Bprepared/FB-32-CD32-Expansions/README.md

# FB-32-CD32-Expansions

This is a Commodore Amiga CD32 Expansion Project. The core of which is the FB-32R Riser which has been verified as working with the TerribleFire TF328
