Bprepared/FB-32-CD32-Expansions/FB-32G/KICAD/Rev2_2/FB-32Gamer Module Rev2_2.kicad_pcb

## KiCad design FB-32G/KICAD/Rev2_2/FB-32Gamer Module Rev2_2.kicad_pcb (2019-09-12)

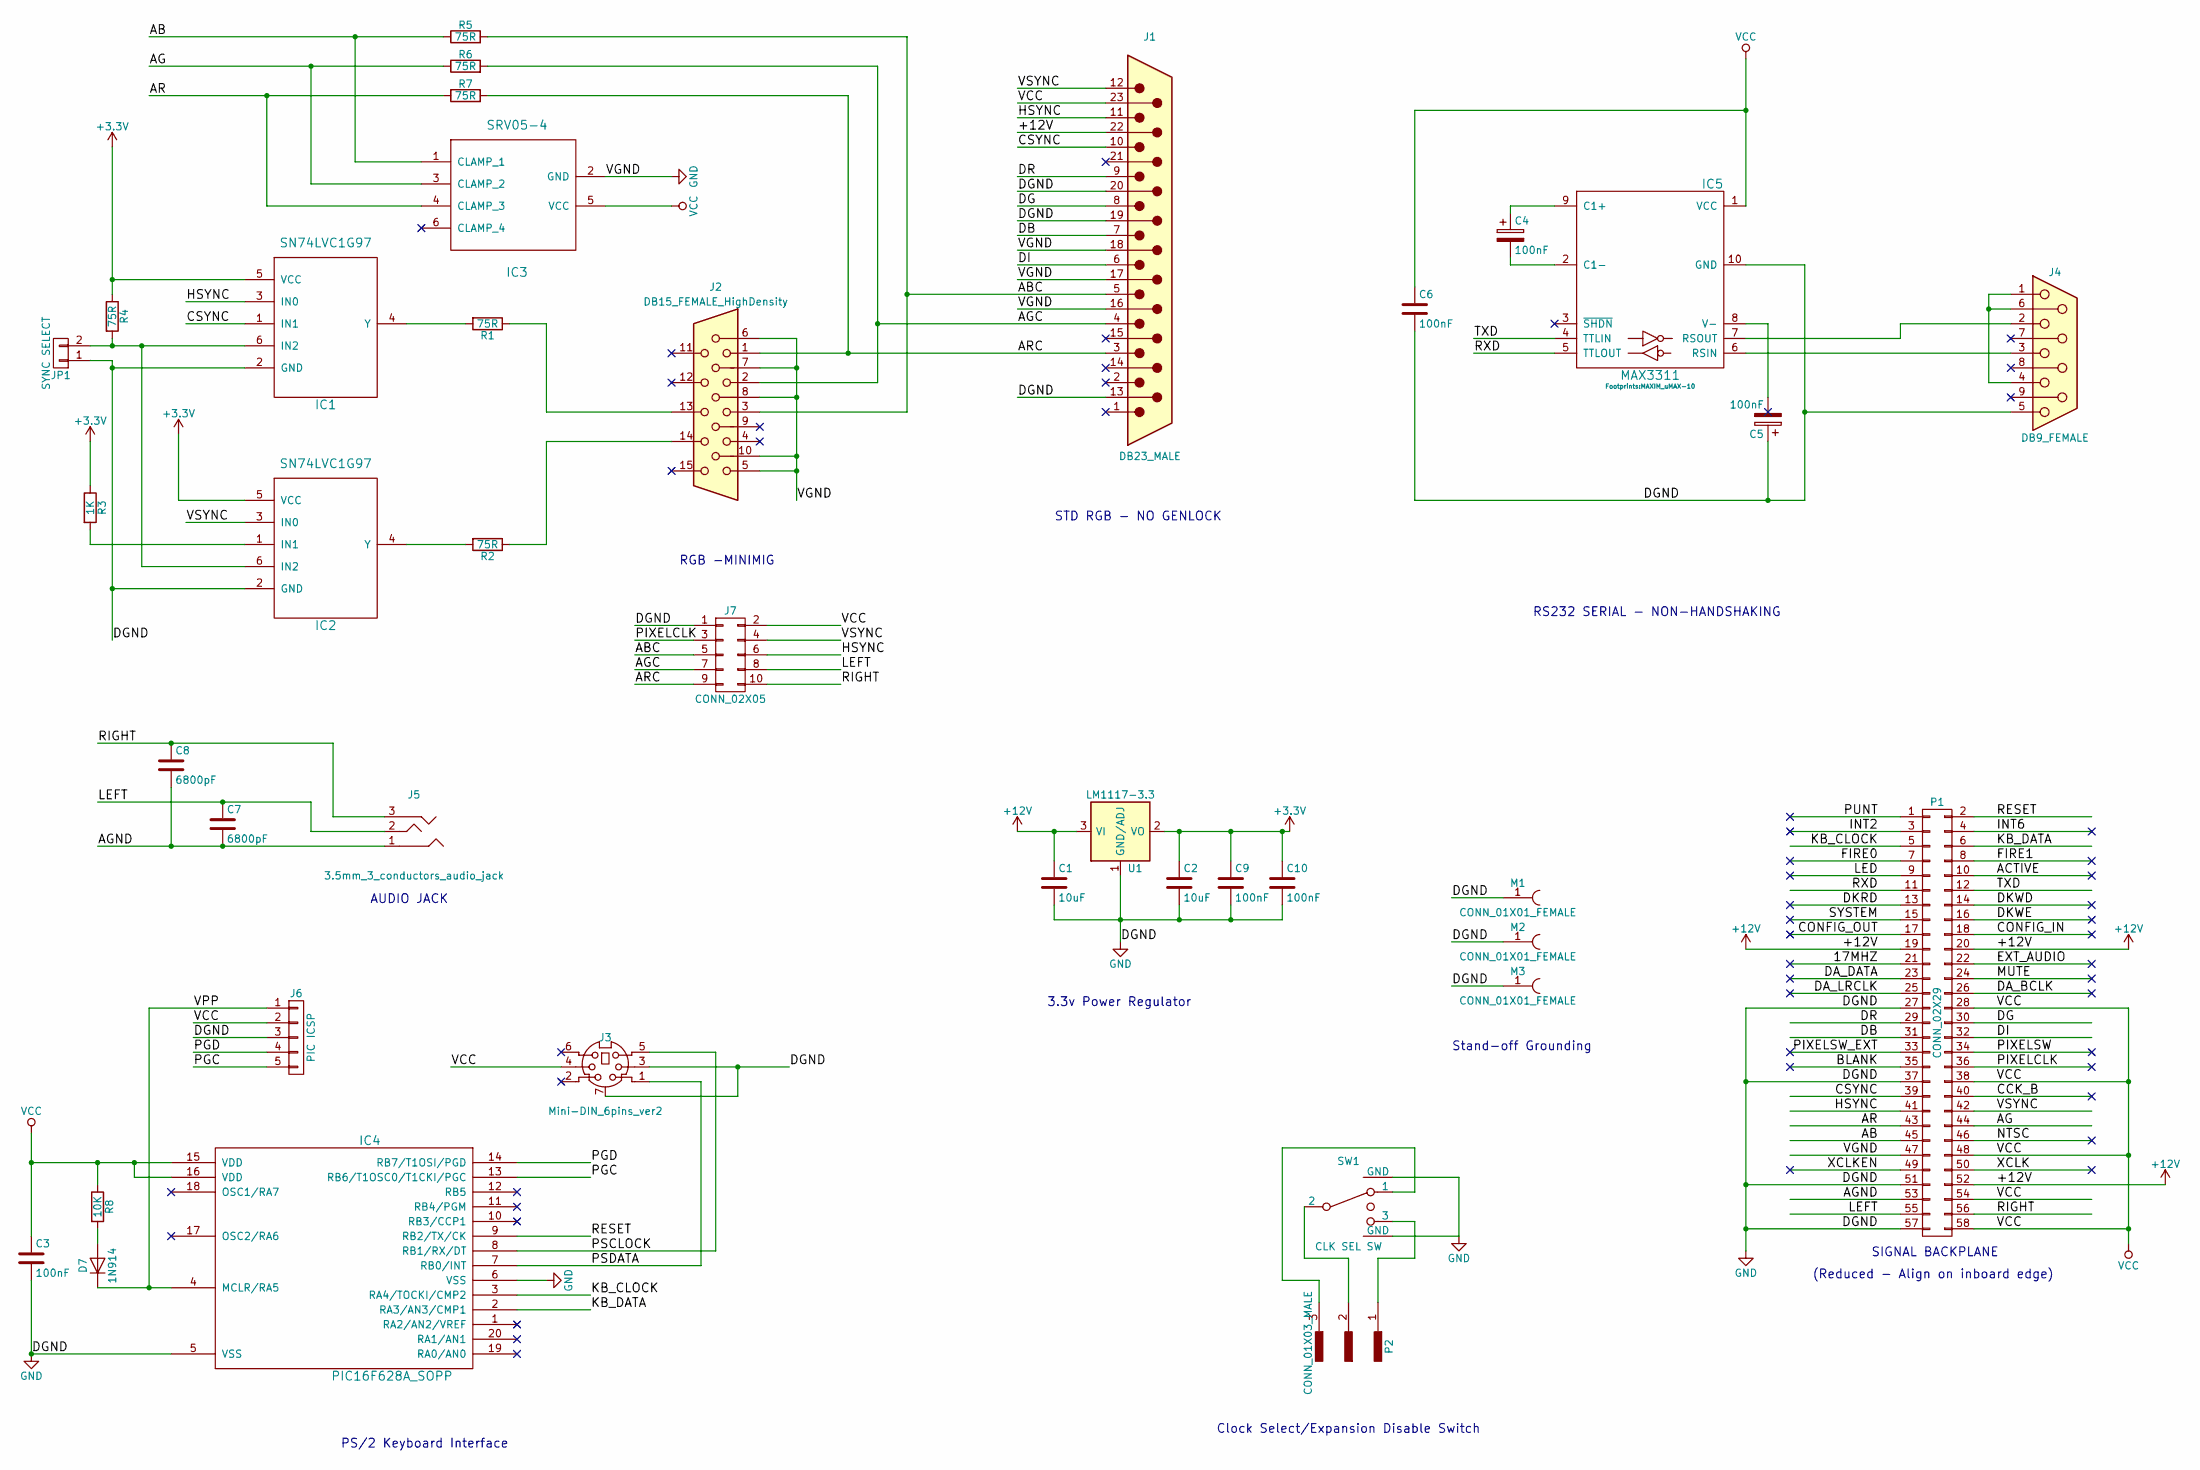
[picture p1: schematic FB-32Gamer Module Rev2_2.sch]

Parts:
C1, C2: 10uF; C_1206_HandSoldering
C3, C6, C9, C10: 100nF; C_0603_HandSoldering
C4, C5: 100nF; CP_Elec_3x5.3
C7, C8: 6800pF; C_0603_HandSoldering
D7: 1N914; D_SOD-323_HandSoldering
IC1, IC2: SN74LVC1G97; SOT-23-6_Handsoldering
IC3: SRV05-4; SOT-23-6_Handsoldering
IC4: PIC16F628A_SOPP; SSOP-20_5.3x7.2mm_Pitch0.65mm
IC5: MAX3311; MAXIM_uMAX-10
J1: DB23_MALE; DB23MDSB
J2: DB15_FEMALE_HighDensity; DB15HD_F
J3: Mini-DIN_6pins_ver2; MD-60SV_6Pin_MiniDIN
J4: DB9_FEMALE; DB9FD
J5: 3.5mm_3_conductors_audio_jack; CP-3523SJTR-ND_SMT_AUDIO_JACK
J6: PIC ICSP; Pin_Header_Straight_1x05_Pitch2.54mm
J7: CONN_02X05; Pin_Header_Angled_2x05_Pitch2.00mm
JP1: SYNC SELECT; Pin_Header_Straight_1x03_Pitch2.54mm
M1, M2, M3: CONN_01X01_FEMALE; 1pin
P1: CONN_02X29; Pin_Header_Straight_2x29_Pitch2.00mm
P2: CONN_01X03_MALE; Pin_Header_Angled_1x03_Pitch2.54mm
R1, R2, R4, R5, R6, R7: 75R; R_0603_HandSoldering
R3: 1K; R_0603_HandSoldering
R8: 10K; R_0603_HandSoldering
SW1: CLK SEL SW
U1: LM1117-3.3; SOT-223

Connections:
+3V3: C2.1, C9.1, C10.1, IC1.5 (VCC), IC2.5 (VCC), R3.1, R4.1, U1.2 (VO), U1.4 (VO)
+12V: C1.1, J1.22, P1.19, P1.20, P1.52, U1.3 (VI)
/17MHZ: P1.21
/AB: IC3.1 (CLAMP_1), P1.45, R5.1
/ABC: J1.5, J2.3, J7.5, R5.2
/ACTIVE: P1.10
/AG: IC3.3 (CLAMP_2), P1.44, R6.1
/AGC: J1.4, J2.2, J7.7, R6.2
/AGND: C7.2, C8.2, J5.1 (GND), P1.53
/AR: IC3.4 (CLAMP_3), P1.43, R7.1
/ARC: J1.3, J2.1, J7.9, R7.2
/BLANK: P1.35
/CCK_B: P1.40
/CONFIG_IN: P1.18
/CONFIG_OUT: P1.17
/CSYNC: IC1.1 (IN1), J1.10, P1.39
/DA_BCLK: P1.26
/DA_DATA: P1.23
/DA_LRCLK: P1.25
/DB: J1.7, P1.31
/DG: J1.8, P1.30
/DI: J1.6, P1.32
/DKRD: P1.13
/DKWD: P1.14
/DKWE: P1.16
/DR: J1.9, P1.29
/EXT_AUDIO: P1.22
/FIRE0: P1.7
/FIRE1: P1.8
/HSYNC: IC1.3 (IN0), J1.11, J7.6, P1.41
/INT2: P1.3
/INT6: P1.4
/KB_CLOCK: IC4.3 (RA4/TOCKI/CMP2), P1.5
/KB_DATA: IC4.2 (RA3/AN3/CMP1), P1.6
/LED: P1.9
/LEFT: C7.1, J5.2 (R), J7.8, P1.55
/MUTE: P1.24
/NTSC: P1.46
/PGC: IC4.13 (RB6/T1OSC0/T1CKI/PGC), J6.5
/PGD: IC4.14 (RB7/T1OSI/PGD), J6.4
/PIXELCLK: J7.3, P1.36
/PIXELSW: P1.34
/PIXELSW_EXT: P1.33
/PSCLOCK: IC4.8 (RB1/RX/DT), J3.5
/PSDATA: IC4.7 (RB0/INT), J3.1
/PUNT: P1.1
/RESET: IC4.9 (RB2/TX/CK), P1.2
/RIGHT: C8.1, J5.3 (L), J7.10, P1.56
/RXD: IC5.5 (TTLOUT), P1.11
/SYSTEM: P1.15
/TXD: IC5.4 (TTLIN), P1.12
/VPP: D7.1 (K), IC4.4 (MCLR/RA5), J6.1
/VSYNC: IC2.3 (IN0), J1.12, J7.4, P1.42
/XCLK: P1.50
/XCLKEN: P1.49
GND: C1.2, C2.2, C3.2, C5.1, C6.2, C9.2, C10.2, IC1.2 (GND), IC2.2 (GND), IC3.2 (GND), IC4.5 (VSS), IC4.6 (VSS), IC5.10 (GND), J1.13, J1.16, J1.17, J1.18, J1.19, J1.20, J2.5, J2.6, J2.7, J2.8, J2.10, J3.3, J3.7 (Shell), J4.5, J6.3, J7.1, JP1.1, M1.1, M2.1, M3.1, P1.27, P1.37, P1.47, P1.51, P1.57, SW1.4 (GND), SW1.5 (GND), U1.1 (GND/ADJ)
unnamed: C4.1, IC5.9 (C1+)
unnamed: C4.2, IC5.2 (C1-)
unnamed: C5.2, IC5.8 (V-)
unnamed: D7.2 (A), R8.2
unnamed: IC1.4 (Y), R1.2
unnamed: IC1.6 (IN2), IC2.6 (IN2), JP1.2, R4.2
unnamed: IC2.1 (IN1), R3.2
unnamed: IC2.4 (Y), R2.2
unnamed: IC5.6 (RSIN), J4.3
unnamed: IC5.7 (RSOUT), J4.2
unnamed: J2.13, R1.1
unnamed: J2.14, R2.1
unnamed: J4.1, J4.4, J4.6
unnamed: P2.1, SW1.3
unnamed: P2.2, SW1.2
unnamed: P2.3, SW1.1
VCC: C3.1, C6.1, IC3.5 (VCC), IC4.15 (VDD), IC4.16 (VDD), IC5.1 (VCC), J1.23, J3.4, J6.2, J7.2, P1.28, P1.38, P1.48, P1.54, P1.58, R8.1

Notes on the sheet:
SIGNAL BACKPLANE
RGB -MINIMIG
STD RGB - NO GENLOCK
RS232 SERIAL - NON-HANDSHAKING
3.3v Power Regulator
Clock Select/Expansion Disable Switch
PS/2 Keyboard Interface
Stand-off Grounding
(Reduced - Align on inboard edge)
AUDIO JACK

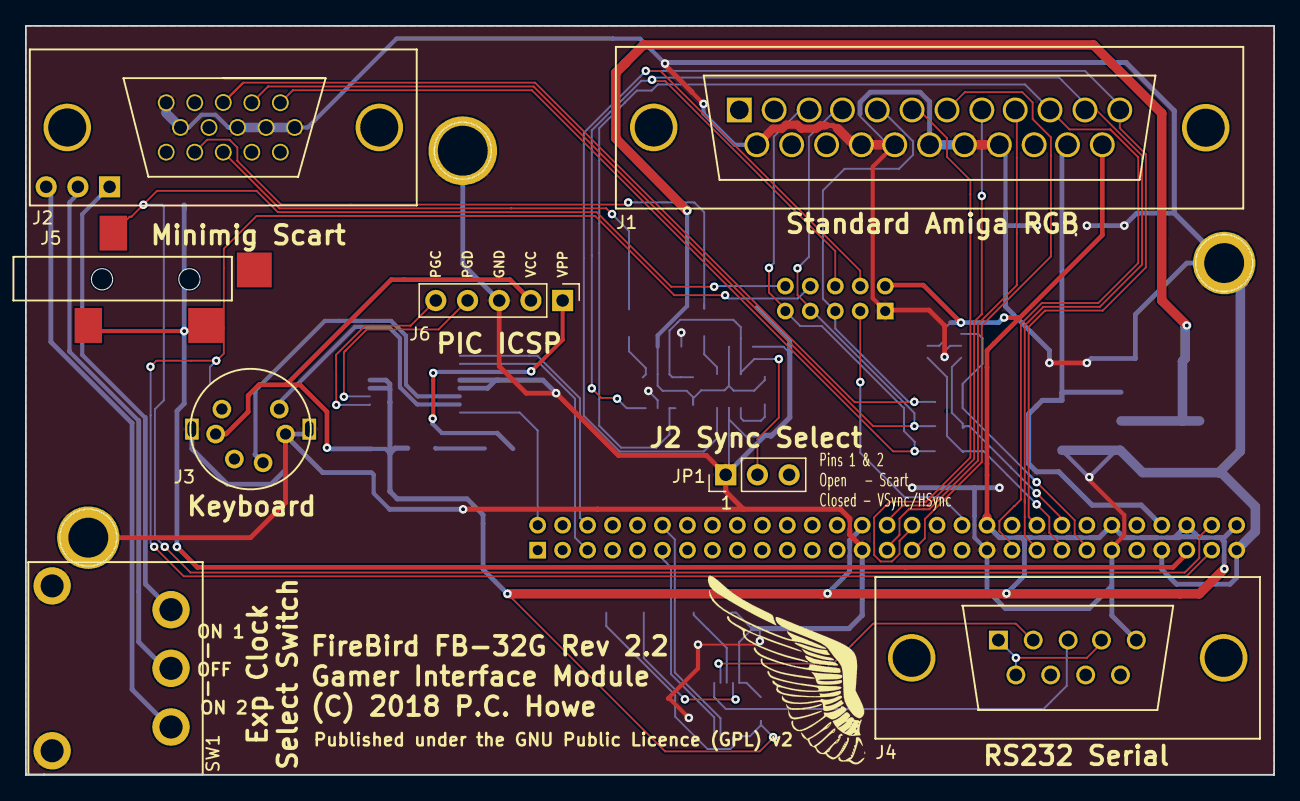
[picture p2: board FB-32Gamer Module Rev2_2.kicad_pcb from above]

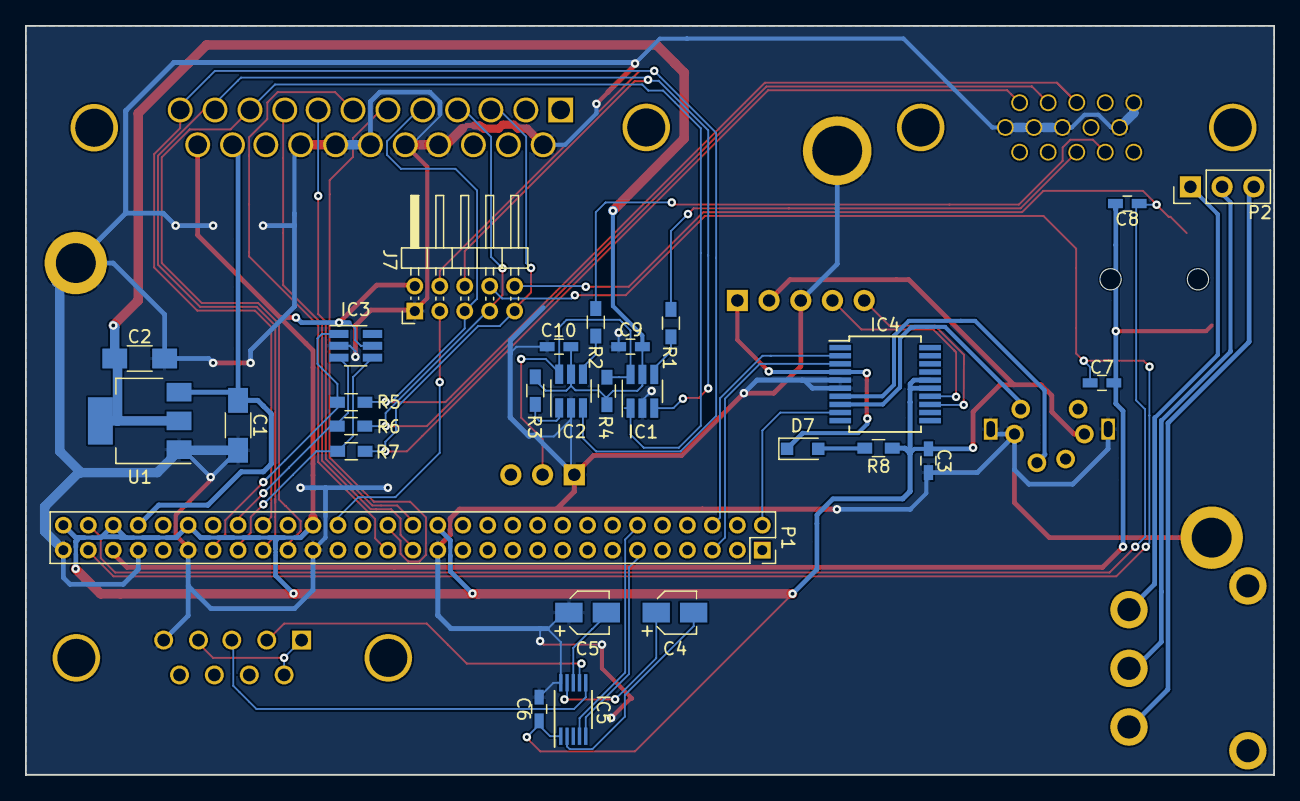
[picture p3: board FB-32Gamer Module Rev2_2.kicad_pcb from below]

Board: 2 copper layers, 100.0 x 60.0 mm, 39 parts (27 on the bottom side), 47 nets.
