Bprepared/FB-32-CD32-Expansions/FB-32R/KiCAD/FB-32R Riser.kicad_pcb

## KiCad design FB-32R/KiCAD/FB-32R Riser.kicad_pcb (2017-10-27)

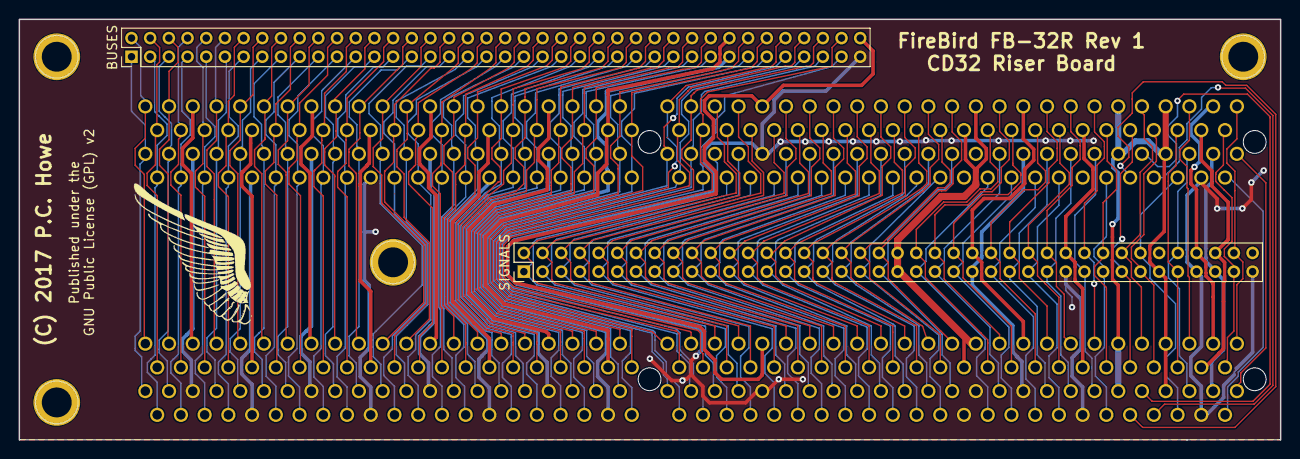
[picture p4: board FB-32R Riser.kicad_pcb from above]

Board: 2 copper layers, 135.0 x 45.0 mm, 8 parts (0 on the bottom side), 153 nets.

Parts:
BUSES: CONN_02X40; Pin_Header_Straight_2x40_Pitch2.00mm
J1 - CD32, J2 - EXP CARD: MCA-182; MCA-182EDGESKT
M1, M2, M3, M4: CONN_01X01_FEMALE; 1pin
SIGNALS: CONN_02X40; Pin_Header_Straight_2x40_Pitch2.00mm

Connections:
/17MHZ: J1 - CD32.139, J2 - EXP CARD.139, SIGNALS.43
/+12V: J1 - CD32.136, J1 - CD32.138, J1 - CD32.178, J2 - EXP CARD.136, J2 - EXP CARD.138, J2 - EXP CARD.178, SIGNALS.41, SIGNALS.42, SIGNALS.74
/A0: BUSES.32, J1 - CD32.38, J2 - EXP CARD.38
/A1: BUSES.31, J1 - CD32.37, J2 - EXP CARD.37
/A2: BUSES.30, J1 - CD32.36, J2 - EXP CARD.36
/A3: BUSES.29, J1 - CD32.35, J2 - EXP CARD.35
/A4: BUSES.28, J1 - CD32.34, J2 - EXP CARD.34
/A5: BUSES.27, J1 - CD32.33, J2 - EXP CARD.33
/A6: BUSES.26, J1 - CD32.32, J2 - EXP CARD.32
/A7: BUSES.25, J1 - CD32.31, J2 - EXP CARD.31
/A8: BUSES.24, J1 - CD32.28, J2 - EXP CARD.28
/A9: BUSES.23, J1 - CD32.27, J2 - EXP CARD.27
/A10: BUSES.22, J1 - CD32.26, J2 - EXP CARD.26
/A11: BUSES.21, J1 - CD32.25, J2 - EXP CARD.25
/A12: BUSES.20, J1 - CD32.24, J2 - EXP CARD.24
/A13: BUSES.19, J1 - CD32.23, J2 - EXP CARD.23
/A14: BUSES.18, J1 - CD32.22, J2 - EXP CARD.22
/A15: BUSES.17, J1 - CD32.21, J2 - EXP CARD.21
/A16: BUSES.16, J1 - CD32.18, J2 - EXP CARD.18
/A17: BUSES.15, J1 - CD32.17, J2 - EXP CARD.17
/A18: BUSES.14, J1 - CD32.16, J2 - EXP CARD.16
/A19: BUSES.13, J1 - CD32.15, J2 - EXP CARD.15
/A20: BUSES.12, J1 - CD32.14, J2 - EXP CARD.14
/A21: BUSES.11, J1 - CD32.13, J2 - EXP CARD.13
/A22: BUSES.10, J1 - CD32.12, J2 - EXP CARD.12
/A23: BUSES.9, J1 - CD32.11, J2 - EXP CARD.11
/A24: BUSES.8, J1 - CD32.8, J2 - EXP CARD.8
/A25: BUSES.7, J1 - CD32.7, J2 - EXP CARD.7
/A26: BUSES.6, J1 - CD32.6, J2 - EXP CARD.6
/A27: BUSES.5, J1 - CD32.5, J2 - EXP CARD.5
/A28: BUSES.4, J1 - CD32.4, J2 - EXP CARD.4
/A29: BUSES.3, J1 - CD32.3, J2 - EXP CARD.3
/A30: BUSES.2, J1 - CD32.2, J2 - EXP CARD.2
/A31: BUSES.1, J1 - CD32.1, J2 - EXP CARD.1
/AB: J1 - CD32.168, J2 - EXP CARD.168, SIGNALS.67
/AB_EXT: J1 - CD32.167, J2 - EXP CARD.167
/ACTIVE: J1 - CD32.126, J2 - EXP CARD.126, SIGNALS.32
/AG: J1 - CD32.166, J2 - EXP CARD.166, SIGNALS.66
/AGND: J1 - CD32.177, J2 - EXP CARD.177, SIGNALS.75
/AG_EXT: J1 - CD32.165, J2 - EXP CARD.165
/AR: J1 - CD32.164, J2 - EXP CARD.164, SIGNALS.65
/AR_EXT: J1 - CD32.163, J2 - EXP CARD.163
/AS: BUSES.77, J1 - CD32.91, J2 - EXP CARD.91
/AVEC: J1 - CD32.96, J2 - EXP CARD.96, SIGNALS.4
/BERR: J1 - CD32.94, J2 - EXP CARD.94, SIGNALS.2
/BLANK: J1 - CD32.153, J2 - EXP CARD.153, SIGNALS.57
/CBACK: J1 - CD32.110, J2 - EXP CARD.110, SIGNALS.16
/CBREQ: J1 - CD32.109, J2 - EXP CARD.109, SIGNALS.15
/CCK_B: J1 - CD32.158, J2 - EXP CARD.158, SIGNALS.62
/CIIN: J1 - CD32.107, J2 - EXP CARD.107, SIGNALS.13
/CIOUT: J1 - CD32.108, J2 - EXP CARD.108, SIGNALS.14
/CONFIG_IN: J1 - CD32.134, J2 - EXP CARD.134, SIGNALS.40
/CONFIG_OUT: J1 - CD32.133, J2 - EXP CARD.133, SIGNALS.39
/CPUCLK_A: J1 - CD32.99, J2 - EXP CARD.99, SIGNALS.7
/CPU_BG: J1 - CD32.113, J2 - EXP CARD.113, SIGNALS.19
/CPU_BGACK: J1 - CD32.115, J2 - EXP CARD.115, SIGNALS.21
/CPU_BR: J1 - CD32.111, J2 - EXP CARD.111, SIGNALS.17
/CSYNC: J1 - CD32.157, J2 - EXP CARD.157, SIGNALS.61
/D0: BUSES.64, J1 - CD32.78, J2 - EXP CARD.78
/D1: BUSES.63, J1 - CD32.77, J2 - EXP CARD.77
/D2: BUSES.62, J1 - CD32.76, J2 - EXP CARD.76
/D3: BUSES.61, J1 - CD32.75, J2 - EXP CARD.75
/D4: BUSES.60, J1 - CD32.74, J2 - EXP CARD.74
/D5: BUSES.59, J1 - CD32.73, J2 - EXP CARD.73
/D6: BUSES.58, J1 - CD32.72, J2 - EXP CARD.72
/D7: BUSES.57, J1 - CD32.71, J2 - EXP CARD.71
/D8: BUSES.56, J1 - CD32.68, J2 - EXP CARD.68
/D9: BUSES.55, J1 - CD32.67, J2 - EXP CARD.67
/D10: BUSES.54, J1 - CD32.66, J2 - EXP CARD.66
/D11: BUSES.53, J1 - CD32.65, J2 - EXP CARD.65
/D12: BUSES.52, J1 - CD32.64, J2 - EXP CARD.64
/D13: BUSES.51, J1 - CD32.63, J2 - EXP CARD.63
/D14: BUSES.50, J1 - CD32.62, J2 - EXP CARD.62
/D15: BUSES.49, J1 - CD32.61, J2 - EXP CARD.61
/D16: BUSES.48, J1 - CD32.58, J2 - EXP CARD.58
/D17: BUSES.47, J1 - CD32.57, J2 - EXP CARD.57
/D18: BUSES.46, J1 - CD32.56, J2 - EXP CARD.56
/D19: BUSES.45, J1 - CD32.55, J2 - EXP CARD.55
/D20: BUSES.44, J1 - CD32.54, J2 - EXP CARD.54
/D21: BUSES.43, J1 - CD32.53, J2 - EXP CARD.53
/D22: BUSES.42, J1 - CD32.52, J2 - EXP CARD.52
/D23: BUSES.41, J1 - CD32.51, J2 - EXP CARD.51
/D24: BUSES.40, J1 - CD32.48, J2 - EXP CARD.48
/D25: BUSES.39, J1 - CD32.47, J2 - EXP CARD.47
/D26: BUSES.38, J1 - CD32.46, J2 - EXP CARD.46
/D27: BUSES.37, J1 - CD32.45, J2 - EXP CARD.45
/D28: BUSES.36, J1 - CD32.44, J2 - EXP CARD.44
/D29: BUSES.35, J1 - CD32.43, J2 - EXP CARD.43
/D30: BUSES.34, J1 - CD32.42, J2 - EXP CARD.42
/D31: BUSES.33, J1 - CD32.41, J2 - EXP CARD.41
/DA_BCLK: J1 - CD32.144, J2 - EXP CARD.144, SIGNALS.48
/DA_DATA: J1 - CD32.141, J2 - EXP CARD.141, SIGNALS.45
/DA_LRCLK: J1 - CD32.143, J2 - EXP CARD.143, SIGNALS.47
/DB: J1 - CD32.149, J2 - EXP CARD.149, SIGNALS.53
/DG: J1 - CD32.148, J2 - EXP CARD.148, SIGNALS.52
/DGND: BUSES.65, BUSES.79, J1 - CD32.9, J1 - CD32.19, J1 - CD32.29, J1 - CD32.39, J1 - CD32.49, J1 - CD32.59, J1 - CD32.69, J1 - CD32.79, J1 - CD32.101, J1 - CD32.135, J1 - CD32.137, J1 - CD32.145, J1 - CD32.155, J1 - CD32.175, J2 - EXP CARD.9, J2 - EXP CARD.19, J2 - EXP CARD.29, J2 - EXP CARD.39, J2 - EXP CARD.49, J2 - EXP CARD.59, J2 - EXP CARD.69, J2 - EXP CARD.79, J2 - EXP CARD.101, J2 - EXP CARD.135, J2 - EXP CARD.137, J2 - EXP CARD.145, J2 - EXP CARD.155, J2 - EXP CARD.175, M1.1, M2.1, M3.1, M4.1, SIGNALS.49, SIGNALS.59, SIGNALS.73, SIGNALS.79
/DI: J1 - CD32.150, J2 - EXP CARD.150, SIGNALS.54
/DKRD: J1 - CD32.129, J2 - EXP CARD.129, SIGNALS.35
/DKWD: J1 - CD32.130, J2 - EXP CARD.130, SIGNALS.36
/DKWE: J1 - CD32.132, J2 - EXP CARD.132, SIGNALS.38
/DR: J1 - CD32.147, J2 - EXP CARD.147, SIGNALS.51
/DS: BUSES.78, J1 - CD32.92, J2 - EXP CARD.92
/DSACK0: J1 - CD32.98, J2 - EXP CARD.98, SIGNALS.6
/DSACK1: J1 - CD32.97, J2 - EXP CARD.97, SIGNALS.5
/E: J1 - CD32.100, J2 - EXP CARD.100, SIGNALS.8
/ECS: BUSES.73, J1 - CD32.87, J2 - EXP CARD.87
/EXPBG: J1 - CD32.112, J2 - EXP CARD.112, SIGNALS.18
/EXP_BGACK: J1 - CD32.116, J2 - EXP CARD.116, SIGNALS.22
/EXP_BR: J1 - CD32.114, J2 - EXP CARD.114, SIGNALS.20
/EXT_AUDIO: J1 - CD32.140, J2 - EXP CARD.140, SIGNALS.44
/EXT_VIDEO: J1 - CD32.174, J2 - EXP CARD.174
/FC0: J1 - CD32.105, J2 - EXP CARD.105, SIGNALS.11
/FC1: J1 - CD32.104, J2 - EXP CARD.104, SIGNALS.10
/FC2: J1 - CD32.103, J2 - EXP CARD.103, SIGNALS.9
/FIRE0: J1 - CD32.123, J2 - EXP CARD.123, SIGNALS.29
/FIRE1: J1 - CD32.124, J2 - EXP CARD.124, SIGNALS.30
/HALT: BUSES.72, J1 - CD32.86, J2 - EXP CARD.86
/HSYNC: J1 - CD32.159, J2 - EXP CARD.159, SIGNALS.63
/INT2: J1 - CD32.119, J2 - EXP CARD.119, SIGNALS.25
/INT6: J1 - CD32.120, J2 - EXP CARD.120, SIGNALS.26
/IPEND: BUSES.70, J1 - CD32.84, J2 - EXP CARD.84
/IPL0: BUSES.69, J1 - CD32.83, J2 - EXP CARD.83
/IPL1: BUSES.68, J1 - CD32.82, J2 - EXP CARD.82
/IPL2: BUSES.67, J1 - CD32.81, J2 - EXP CARD.81
/KB_CLOCK: J1 - CD32.121, J2 - EXP CARD.121, SIGNALS.27
/KB_DATA: J1 - CD32.122, J2 - EXP CARD.122, SIGNALS.28
/LED: J1 - CD32.125, J2 - EXP CARD.125, SIGNALS.31
/LEFT: J1 - CD32.180, J2 - EXP CARD.180, SIGNALS.77
/LEFT_EXT: J1 - CD32.179, J2 - EXP CARD.179
/MUTE: J1 - CD32.142, J2 - EXP CARD.142, SIGNALS.46
/NTSC: J1 - CD32.171, J2 - EXP CARD.171, SIGNALS.68
/OCS: BUSES.74, J1 - CD32.88, J2 - EXP CARD.88
/PIXELCLK: J1 - CD32.154, J2 - EXP CARD.154, SIGNALS.58
/PIXELSW: J1 - CD32.152, J2 - EXP CARD.152, SIGNALS.56
/PIXELSW_EXT: J1 - CD32.151, J2 - EXP CARD.151, SIGNALS.55
/PUNT: J1 - CD32.117, J2 - EXP CARD.117, SIGNALS.23
/R/W: J1 - CD32.93, J2 - EXP CARD.93, SIGNALS.1
/RESET: J1 - CD32.118, J2 - EXP CARD.118, SIGNALS.24
/RIGHT: J1 - CD32.182, J2 - EXP CARD.182, SIGNALS.78
/RIGHT_EXT: J1 - CD32.181, J2 - EXP CARD.181
/RMC: J1 - CD32.106, J2 - EXP CARD.106, SIGNALS.12
/RST: BUSES.71, J1 - CD32.85, J2 - EXP CARD.85
/RXD: J1 - CD32.127, J2 - EXP CARD.127, SIGNALS.33
/SIZE0: BUSES.76, J1 - CD32.90, J2 - EXP CARD.90
/SIZE1: BUSES.75, J1 - CD32.89, J2 - EXP CARD.89
/STERM: J1 - CD32.95, J2 - EXP CARD.95, SIGNALS.3
/SYSTEM: J1 - CD32.131, J2 - EXP CARD.131, SIGNALS.37
/TXD: J1 - CD32.128, J2 - EXP CARD.128, SIGNALS.34
/VGND: J1 - CD32.161, J1 - CD32.162, J1 - CD32.169, J1 - CD32.170, J2 - EXP CARD.161, J2 - EXP CARD.162, J2 - EXP CARD.169, J2 - EXP CARD.170, SIGNALS.69
/VSYNC: J1 - CD32.160, J2 - EXP CARD.160, SIGNALS.64
/XCLK: J1 - CD32.173, J2 - EXP CARD.173, SIGNALS.72
/XCLKEN: J1 - CD32.172, J2 - EXP CARD.172, SIGNALS.71
VCC: BUSES.66, BUSES.80, J1 - CD32.10, J1 - CD32.20, J1 - CD32.30, J1 - CD32.40, J1 - CD32.50, J1 - CD32.60, J1 - CD32.70, J1 - CD32.80, J1 - CD32.102, J1 - CD32.146, J1 - CD32.156, J1 - CD32.176, J2 - EXP CARD.10, J2 - EXP CARD.20, J2 - EXP CARD.30, J2 - EXP CARD.40, J2 - EXP CARD.50, J2 - EXP CARD.60, J2 - EXP CARD.70, J2 - EXP CARD.80, J2 - EXP CARD.102, J2 - EXP CARD.146, J2 - EXP CARD.156, J2 - EXP CARD.176, SIGNALS.50, SIGNALS.60, SIGNALS.70, SIGNALS.76, SIGNALS.80
