Bprepared/FB-32-CD32-Expansions/(notices)

Notices in the files:
FB-32R/KiCAD/FB-32R Riser.kicad_pcb:
(C) 2017 P.C. Howe
Published under the
GNU Public License (GPL) v2
FB-32G/KICAD/Rev2_2/FB-32Gamer Module Rev2_2.kicad_pcb:
(C) 2018 P.C. Howe
Published under the GNU Public Licence (GPL) v2
